alencar-felipe/mea-craft/report/schema0.pdf

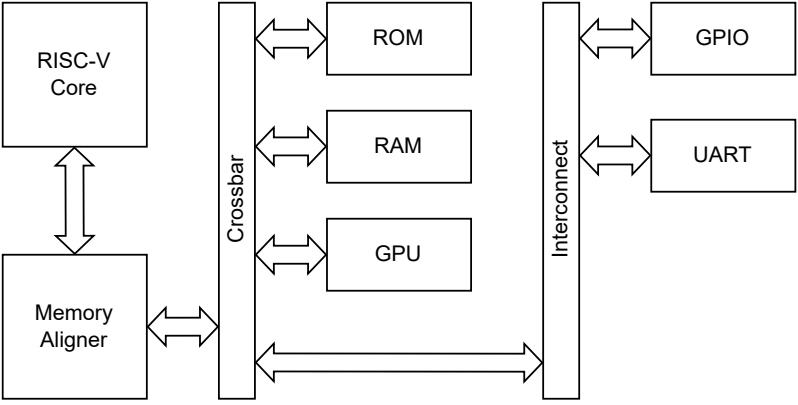
[picture p7: figure]
RISC-V Core; Memory Aligner; Crossbar; ROM; RAM; GPU; Interconnect; GPIO; UAR
