alencar-felipe/mea-craft/report/schema2.pdf

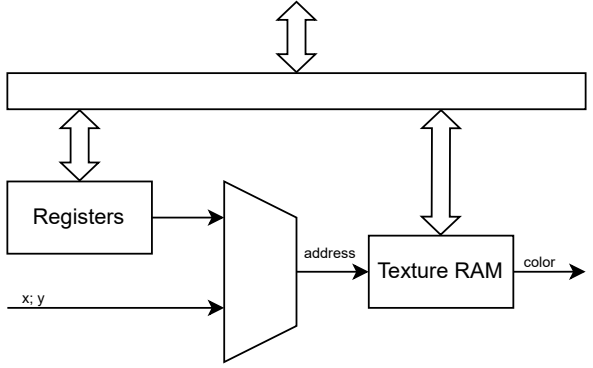
[picture p8: figure]
Registers; Texture RAM; color address
