alencar-felipe/mea-craft/report/schema4.pdf

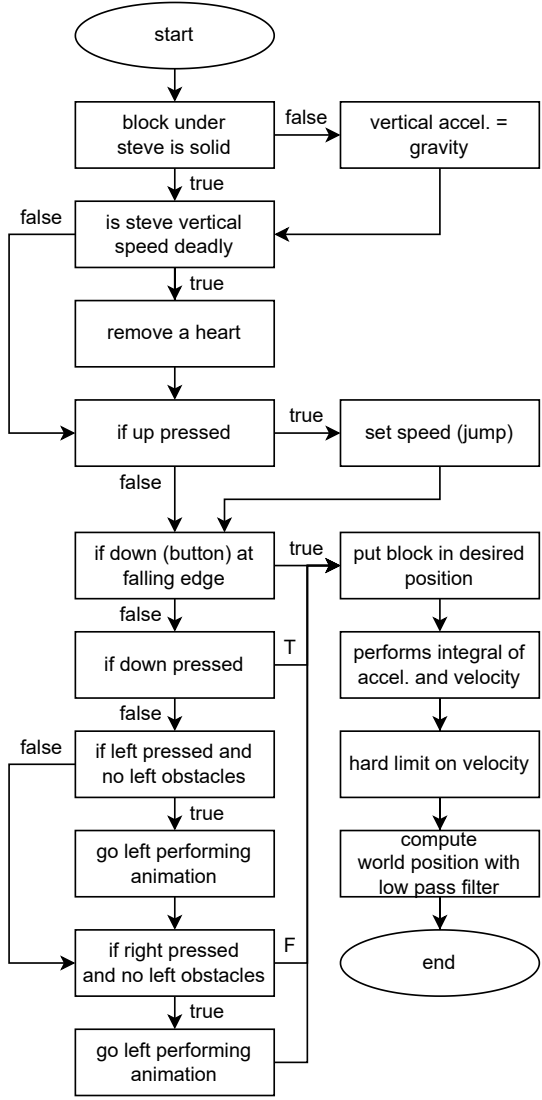
[picture p9: page 1]
start; vertical accel. = gravity; remove a heart; if up pressed; set speed (jump); true; false; end

block under
steve is solid

is steve vertical
speed deadly

if down (button) at
falling edge
false

true
put block in desired
position

performs integral of
accel. and velocity

if down pressed

if left pressed and
no left obstacles

hard limit on velocity

compute
world position with
low pass filter

go left performing
animation

if right pressed
and no left obstacles
