alencar-felipe/mea-craft/report/schema3.pdf

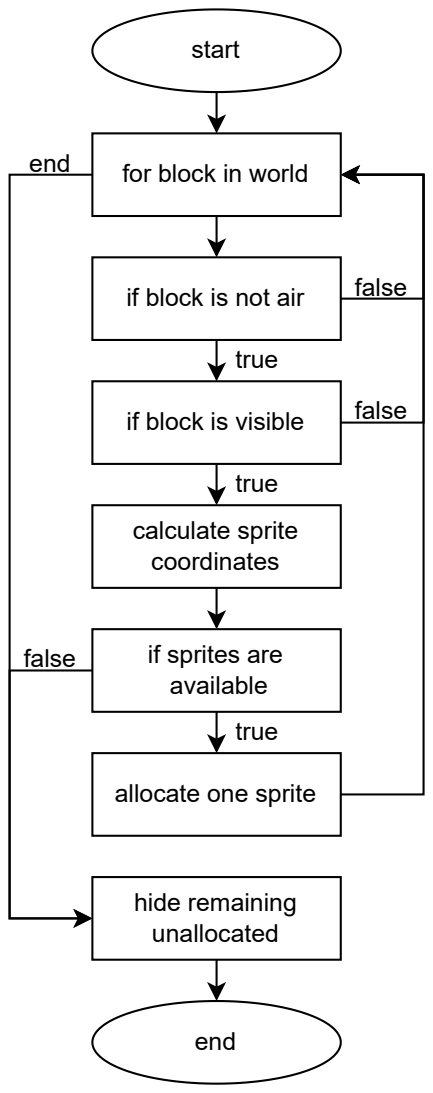
[picture p10: page 1]
calculate sprite coordinates; hide remaining unallocated; false; true; end; start

for block in world

if block is not air

if block is visible

if sprites are
available
true

allocate one sprite
