alencar-felipe/mea-craft/report/schema1.pdf

## Cluster 0

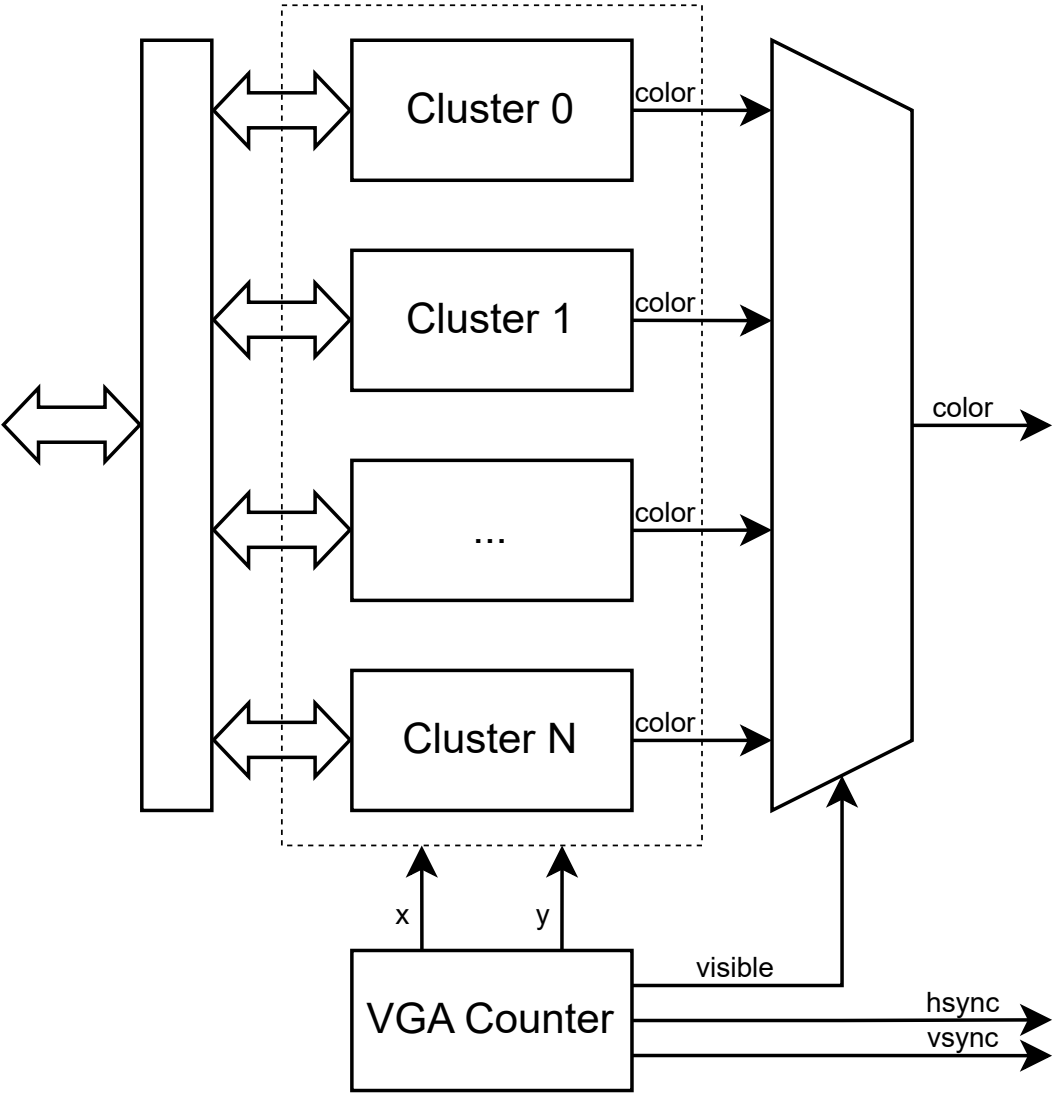
[picture p11: page 1]
Cluster 1; Cluster N; color; VGA Counter; visible; hsync vsync
