alencar-felipe/mea-craft/software/inc/hardware.h

#pragma once

#include "mylib.h"

#define ROM_BASE            (0x00000000)
#define RAM_BASE            (0x10000000)
#define GPU_BASE            (0x20000000)
#define PERIPHERALS_BASE    (0x30000000)

/* GPU ====================================================================== */

#define GPU_W        (640)
#define GPU_H        (480)
#define GPU_CL_COUNT (5)
#define GPU_CL_SIZE  (16)
#define GPU_TEXT_W   (64)
#define GPU_TEXT_H   (64)

typedef struct __attribute__((packed)) {
    int16_t sx;
    int16_t reserved0;
    int16_t sy;
    int16_t reserved1;
    int16_t stx;
    int16_t reserved2;
    int16_t sty;
    int16_t reserved3;
    int16_t stw;
    int16_t reserved4;
    int16_t sth;
    int16_t reserved5;
} sprite_t;

typedef struct __attribute__((packed)) {
    sprite_t sprites[GPU_CL_SIZE];
    uint32_t texture[GPU_TEXT_H][GPU_TEXT_W];
} cluster_t;

typedef struct __attribute__((packed)) {
    cluster_t clusters[GPU_CL_COUNT];
} gpu_t;

#define GPU ( (volatile gpu_t *) (GPU_BASE) )

/* Peripherals ============================================================== */

#define UART_BASE           (PERIPHERALS_BASE + 0x000000)
#define GPIO_BASE           (PERIPHERALS_BASE + 0x010000)
#define PS2_BASE            (PERIPHERALS_BASE + 0x020000)

/* Peripherals / UART ======================================================= */

typedef struct __attribute__((packed)) {
    uint32_t data;
    uint8_t  sts_tx : 1;
    uint8_t  stx_rx : 1;
    uint32_t reserved : 30;
} uart_t;

#define UART ( (volatile uart_t *) (UART_BASE) )

/* Peripherals / GPIO ======================================================= */

#define GPIO_A              (GPIO_BASE + 0x0000)
#define GPIO_B              (GPIO_BASE + 0x0004)

typedef struct __attribute__((packed)) {
    uint16_t sw : 16;
    uint8_t  btn_u : 1;
    uint8_t  btn_l : 1;
    uint8_t  btn_r : 1;
    uint8_t  btn_d : 1;
    uint32_t reserved : 12;
} gpio_a_in_t;

typedef struct __attribute__((packed)) {
    uint16_t led : 16;
    uint16_t reserved : 15;
    uint8_t  texture_lock : 1;
} gpio_a_out_t;

typedef struct __attribute__((packed)) {
    uint32_t frame_counter : 32;
} gpio_b_in_t;

typedef struct __attribute__((packed)) {
    uint32_t frame_counter : 32;
} gpio_b_out_t;

#define GPIO_A_IN  ( (volatile gpio_a_in_t  *) GPIO_A )
#define GPIO_A_OUT ( (volatile gpio_a_out_t *) GPIO_A )
#define GPIO_B_IN  ( (volatile gpio_b_in_t  *) GPIO_B )
#define GPIO_B_OUT ( (volatile gpio_b_out_t *) GPIO_B )

/* Peripherals / PS2 ======================================================== */

// #define PS2_FRAME           (PS2_BASE + 0x0000)
// #define PS2_STS             (PS2_BASE + 0x0004)

// #define PS2_FRAME_POS       (0)
// #define PS2_FRAME_MSK       (0xFF << PS2_FRAME_POS)

// #define PS2_STS_POS         (0)
// #define PS2_STS_MSK         (1 << PS2_STS_POS)

/* Helpers ================================================================== */

#define WRITE_WORD(ADDR, WORD) (*((volatile uint32_t *)(ADDR)) = (uint32_t) (WORD))
#define WRITE_HALF(ADDR, HALF) (*((volatile uint16_t *)(ADDR)) = (uint16_t) (HALF))
#define WRITE_BYTE(ADDR, BYTE) (*((volatile uint8_t  *)(ADDR)) = (uint8_t ) (BYTE))
#define READ_WORD(ADDR) (*((volatile uint32_t *)(ADDR)))
#define READ_HALF(ADDR) (*((volatile uint16_t *)(ADDR)))
#define READ_BYTE(ADDR) (*((volatile uint8_t  *)(ADDR)))

inline void enable_interrupt()
{
    asm volatile (
        "li t0, 0x00000800 \n"
        "csrrs x0, mie, t0 \n"
    );
}

inline void disable_interrupt()
{
    asm volatile (
        "li t0, 0x00000800 \n"
        "csrrc x0, mie, t0 \n"
    );
}
