alencar-felipe/mea-craft/hardware/design/gpu/gpu.sv

module gpu #(
    parameter DATA_WIDTH = 32,
    parameter ADDR_WIDTH = 24,
    parameter STRB_WIDTH = (DATA_WIDTH/8),

    parameter TEXTURE_WIDTH  = 64,
    parameter TEXTURE_HEIGHT = 64,
    parameter CLUSTER_COUNT  = 5,
    parameter CLUSTER_SIZE   = 16,

    parameter integer CLUSTER_SCALE [CLUSTER_COUNT] = '{2,4,4,4,4}    
) (
    input  logic clk, // 50 MHz
    input  logic rst,

    input  logic [ADDR_WIDTH-1:0] axil_awaddr,
    input  logic [2:0]            axil_awprot,
    input  logic                  axil_awvalid,
    output logic                  axil_awready,
    input  logic [DATA_WIDTH-1:0] axil_wdata,
    input  logic [STRB_WIDTH-1:0] axil_wstrb,
    input  logic                  axil_wvalid,
    output logic                  axil_wready,
    output logic [1:0]            axil_bresp,
    output logic                  axil_bvalid,
    input  logic                  axil_bready,

    output logic [3:0] red,
    output logic [3:0] green,
    output logic [3:0] blue,

    output logic hsync,
    output logic vsync,

    output logic [DATA_WIDTH-1:0] counter,

    input  logic texture_lock
);
    localparam WIDTH  = 640;
    localparam HEIGHT = 480;
    localparam INT_WIDTH = 16;
    localparam COLOR_WIDTH = 12;
    
    localparam TEXTURE_SIZE = TEXTURE_WIDTH*TEXTURE_HEIGHT;
    localparam CLUSTER_ADDR_SIZE = CLUSTER_SIZE*6 + TEXTURE_SIZE;

    logic clk25;
    logic rst25;
    
    logic [INT_WIDTH-1:0] x;
    logic [INT_WIDTH-1:0] y;
    logic visible;
    
    logic [ADDR_WIDTH-1:0] waddr;
    logic [DATA_WIDTH-1:0] wdata;
    logic                  wen;

    logic [ADDR_WIDTH-1:0]  cluster_waddr;
    logic [DATA_WIDTH-1:0]  cluster_wdata;
    logic [COLOR_WIDTH-1:0] cluster_pixel [CLUSTER_COUNT-1:0];
    logic                   cluster_wen   [CLUSTER_COUNT-1:0];

    logic [COLOR_WIDTH-1:0] pixel;

    logic last_vsync;

    clkdiv #(
        .DIV (2)
    ) clkdiv (
        .clk_in (clk),
        .rst_in (rst),
        .clk_out (clk25),
        .rst_out (rst25)
    );

    vga_counter #(
        .WIDTH  (WIDTH),
        .HEIGHT (HEIGHT),
        .HSP    ( 96),
        .HBP    ( 48),
        .HFP    ( 16),
        .VSP    (  2),
        .VBP    ( 29),
        .VFP    ( 10),

        .INT_WIDTH (INT_WIDTH)
    ) vga_counter (
        .clk (clk25),
        .rst (rst25),

        .hsync (hsync),
        .vsync (vsync),

        .x (x),
        .y (y),

        .visible (visible)
    );

    axil_controller #(
        .ADDR_WIDTH (ADDR_WIDTH),
        .DATA_WIDTH (DATA_WIDTH),
        .STRB_WIDTH (STRB_WIDTH)
    ) axil_controller (
        .clk (clk),
        .rst (rst),

        .axil_awaddr  (axil_awaddr),
        .axil_awprot  (axil_awprot),
        .axil_awvalid (axil_awvalid),
        .axil_awready (axil_awready),
        .axil_wdata   (axil_wdata),
        .axil_wstrb   (axil_wstrb), 
        .axil_wvalid  (axil_wvalid),
        .axil_wready  (axil_wready),
        .axil_bresp   (axil_bresp),
        .axil_bvalid  (axil_bvalid),
        .axil_bready  (axil_bready),

        .waddr (waddr),
        .wdata (wdata),
        .wen   (wen)
    );

    generate
        genvar i;
        for (i = 0; i < CLUSTER_COUNT; i++) begin 
            cluster #(
                .CLUSTER_SIZE   (CLUSTER_SIZE),
                .TEXTURE_WIDTH  (TEXTURE_WIDTH),
                .TEXTURE_HEIGHT (TEXTURE_HEIGHT),

                .ADDR_WIDTH  (16),
                .INT_WIDTH   (INT_WIDTH),
                .COLOR_WIDTH (COLOR_WIDTH),
                .SCALE (CLUSTER_SCALE[i])
            ) cluster ( 
                .clk (clk),
                .rst (rst),

                .waddr (cluster_waddr),
                .wdata (cluster_wdata),
                .wen   (cluster_wen[i]),

                .x     (x),
                .y     (y),
                .pixel (cluster_pixel[i]),

                .texture_lock (texture_lock)
            );
        end
    endgenerate

    always_comb begin
        logic [$clog2(CLUSTER_COUNT):0] k;

        if (visible) begin
            pixel = 12'h8CE;
            for (k = 0; k < CLUSTER_COUNT; k++) begin
                if(cluster_pixel[k] != 12'hFFF) begin
                    pixel = cluster_pixel[k];
                    break;
                end
            end
        end
        else begin
            pixel = 0;
        end
    end

    always_comb begin
        logic [$clog2(CLUSTER_COUNT):0] selected;
        logic [$clog2(CLUSTER_COUNT):0] i;

        selected      = waddr[17:2] / CLUSTER_ADDR_SIZE;
        cluster_waddr = waddr[17:2] % CLUSTER_ADDR_SIZE; 
        cluster_wdata = wdata[INT_WIDTH-1:0];

        for (i = 0; i < CLUSTER_COUNT; i++) begin
            if(i == selected) begin
                cluster_wen[i] = wen;
            end
            else begin
                cluster_wen[i] = 0;
            end
        end
    end

    always_ff @(posedge clk25) begin
        red   <= pixel[11: 8];
        green <= pixel[ 7: 4];
        blue  <= pixel[ 3: 0];
    end

    always_ff @(posedge clk) begin
        if (rst) begin
            last_vsync <= 1;
            counter <= 0;
        end
        else begin
            if(vsync == 0 && last_vsync == 1) begin
                counter <= counter + 1;
            end
            last_vsync <= vsync;
        end
    end

endmodule
