alencar-felipe/mea-craft/(commit log)

2023-05-19 uart and memory with unaligned access support
2023-05-27 change of strategy, cleanup, reset fixed, untested ps2, broken printf
    [aligner.sv, basys3.sv, clkdiv.sv, core.sv, csr_file.sv, debouncer.sv, gpio.sv, main.c]
2023-05-27 bug fix: jarl, load byte
    [core.sv, main.c, mem_ctrl_gen.sv, printf.c]
2023-05-27 address bug fix with uart and ps2
    [main.c, peripherals.sv, ps2.sv, uart.sv]
2023-05-27 2d gpu that does not work and uses too much space
    [cluster.sv, flasher.py, gpu.sv, gpu_ram.sv, main.c, top.sv, uart.sv, vga_counter.sv]
2023-05-29 fix: texture linking, color endianness
    [gpu.sv, imgcopy.py, main.c]
2023-05-30 world low pass filter
2023-06-08 x axis collision
2023-06-11 quick fix for gpu addressing bug
    [cluster.sv, gpu.sv, hardware.h, main.c, peripherals.sv, top.sv]
2023-06-12 world flowchart
2023-06-12 game flowchart
